nguyenhainam071205/IOT/Module_cam_bien_va_cong_thuc.docx

# Module cảm biến và công thức tính

Trạm đo lũ dùng ESP32: đo mực nước, lưu lượng và độ ẩm đất, gửi kết quả về web server qua HTTP POST JSON. Tài liệu này liệt kê các module đang dùng và công thức được cài trong firmware (thư mục firmware/).

# 1. Danh sách module

Module | Đại lượng đo | Chân ESP32 | Ghi chú đấu nối
HC-SR04 (siêu âm) | Khoảng cách từ cảm biến đến mặt nước, từ đó tính mực nước | TRIG: GPIO 25 ECHO: GPIO 26 | Cấp 5V (VIN). ECHO ra 5V nên phải qua cầu chia áp 1k/2k trước khi vào GPIO 26.
YF-S201 (lưu lượng) | Lưu lượng nước (L/phút) và tổng thể tích (L) | GPIO 27 | Cấp 5V (VIN). Dây vàng (xung) qua cầu chia áp 1k/2k. Đếm xung bằng ngắt cạnh xuống.
Cảm biến độ ẩm đất (LM393, ngõ AO) | Độ ẩm đất (%) | GPIO 34 (ADC) | Cấp 3V3. Đất khô cho ADC cao, đất ướt cho ADC thấp.

Vi điều khiển: ESP32 (ADC 12 bit, giá trị 0 đến 4095). Cầu chia áp 1k/2k hạ mức 5V xuống 5 x 2/(1+2) = 3,33V, an toàn cho chân GPIO của ESP32.

# 2. Cảm biến siêu âm HC-SR04 và mực nước

## 2.1. Khoảng cách

Cảm biến phát xung siêu âm, đo thời gian t (µs) từ lúc phát đến lúc nhận echo. Sóng đi và về nên chia đôi quãng đường:

v = 331,3 + 0,606 x T (m/s, T là nhiệt độ môi trường °C)

v_cm/µs = v / 10000

D = t x v_cm/µs / 2 + OFFSET_CM (cm)

Firmware dùng TEMP_C = 30 °C nên v = 349,48 m/s = 0,034948 cm/µs. OFFSET_CM = 0 (chỉnh sau khi so với thước). Mỗi mẫu thử tối đa 3 lần nếu mất echo (timeout 30 ms).

## 2.2. Lọc trung bình động

Lấy trung bình N = 5 mẫu gần nhất để giảm nhiễu. Nếu một mẫu mất echo thì giữ nguyên D_loc cũ.

D_loc = (1/N) x SUM( D[n-i] ), i = 0 .. N-1

## 2.3. Mực nước

H_nuoc = H_tram - D_loc (cm)

H_tram = 30 cm là chiều cao lắp cảm biến so với mốc chuẩn (đáy). Nếu H_nuoc < 0 thì coi như 0. Chỉ xét cảnh báo và gửi dữ liệu khi bộ lọc đã đủ 5 mẫu.

## 2.4. Mức cảnh báo

Mức | Điều kiện lên mức | Điều kiện hạ mức (có trễ)
Bình thường (normal) | H_nuoc < 4 cm | H_nuoc < 3,5 cm khi đang ở vàng
Vàng (yellow) | H_nuoc >= 4 cm | H_nuoc < 7,5 cm khi đang ở đỏ
Đỏ (red) | H_nuoc >= 8 cm | Không có mức cao hơn

Độ trễ HYST_CM = 0,5 cm: muốn hạ mức, mực nước phải tụt xuống dưới (ngưỡng - 0,5) để tránh nhấp nháy quanh ngưỡng. Mỗi lần đổi mức, ESP32 gửi ngay bản tin "alert".

## 2.5. Ví dụ

Echo đo được t = 1500 µs: D = 1500 x 0,034948 / 2 = 26,2 cm, nên H_nuoc = 30 - 26,2 = 3,8 cm (mức bình thường).

# 3. Cảm biến lưu lượng YF-S201

Cảm biến phát xung, mỗi cạnh xuống là 1 xung, được đếm bằng ngắt. Tần số xung tỉ lệ với lưu lượng theo datasheet:

f = 7,5 x Q => Q = f / 7,5 (f: Hz, Q: L/phút)

Trong mỗi chu kỳ đo (khoảng 1 giây, chia theo thời gian thực tế elapsed để chính xác khi chu kỳ dài hơn 1 s):

f = số_xung x 1000 / elapsed_ms (Hz)

Q = f / FLOW_K, FLOW_K = 7,5 (L/phút)

Tổng_L = Tổng_L + (Q / 60) x (elapsed_ms / 1000) (lít, cộng dồn)

Ví dụ: đếm được 15 xung trong 1 s thì f = 15 Hz, Q = 2 L/phút, thể tích tăng thêm 2/60 = 0,033 L. Hệ số 7,5 là giá trị danh định, nên hiệu chuẩn lại bằng cách đo một thể tích nước biết trước. Giá trị flow_lpm gửi lên server là giá trị tức thời của chu kỳ ngay trước khi gửi.

# 4. Cảm biến độ ẩm đất (LM393)

Đọc ADC 10 lần (cách nhau 2 ms) rồi lấy trung bình để giảm nhiễu, sau đó quy đổi tuyến tính giữa hai mốc hiệu chuẩn:

W = (ADC_kho - ADC) / (ADC_kho - ADC_uot) x 100 (%)

W được giới hạn trong khoảng [0, 100]

Hằng số | Giá trị | Ý nghĩa
ADC_KHO | 3500 | ADC khi đất khô hoàn toàn (để ngoài không khí)
ADC_UOT | 1400 | ADC khi đất ướt hoàn toàn (nhúng nước)

Hai mốc trên là giá trị ví dụ, cần đo lại bằng chính cảm biến của bạn. Ví dụ: ADC = 2450 thì W = (3500 - 2450) / (3500 - 1400) x 100 = 50%.

# 5. Dữ liệu gửi lên server

ESP32 gửi HTTP POST JSON tới /flood khi đổi mức cảnh báo (event = "alert") và định kỳ 5 giây một lần (event = "report"). Các trường:

Trường | Đơn vị | Nguồn
level | chuỗi | normal / yellow / red theo mục 2.4
h_nuoc_cm | cm | H_nuoc (mục 2.3)
d_loc_cm | cm | D_loc (mục 2.2)
h_tram_cm | cm | H_tram, hằng số cấu hình
flow_lpm | L/phút | Q (mục 3)
total_l | lít | Tổng thể tích cộng dồn (mục 3)
soil_pct | % | W (mục 4)

# 6. Tham số cấu hình

Toàn bộ hằng số nằm trong firmware/config.h:

Hằng số | Giá trị | Ý nghĩa
TEMP_C | 30,0 °C | Nhiệt độ bù tốc độ âm thanh
OFFSET_CM | 0,0 cm | Độ lệch cố định của HC-SR04
H_TRAM_CM | 30,0 cm | Chiều cao lắp cảm biến so với đáy
N_MA | 5 | Số mẫu của bộ lọc trung bình động
YELLOW_CM / RED_CM | 4,0 / 8,0 cm | Ngưỡng cảnh báo vàng / đỏ
HYST_CM | 0,5 cm | Độ trễ khi hạ mức
FLOW_K | 7,5 | Xung/giây ứng với 1 L/phút
ADC_KHO / ADC_UOT | 3500 / 1400 | Mốc hiệu chuẩn độ ẩm đất
INTERVAL_MS | 1000 ms | Chu kỳ đo và in Serial
REPORT_INTERVAL_MS | 5000 ms | Chu kỳ báo cáo định kỳ lên server
