nguyenhainam071205/IOT/(commit log)

2026-11-13 Cap nhat firmware: them module bao dong (den LED + coi) va hien thi LCD 1602 I2C
2026-11-13 Web: hien canh bao do am dat/luu luong, giao dien sang/toi, lam noi bat thoi tiet
    - Canh bao tung cam bien (do am dat, luu luong, lu quet) tren dau trang, vien mau theo muc
    - Bo bieu do sparkline o 3 the chi so
    - Bieu do muc nuoc co dinh 1 gio gan nhat
    - Them nut doi giao dien sang/toi (mac dinh sang, luu trong localStorage)
    - Lam noi bat khoi du bao thoi tiet, icon troi quang ban dem thanh mat trang
2026-11-13 Doi nguong cho hop cao 10 cm: H_TRAM 10, vang 4 cm, do 7 cm
2026-11-13 Cap nhat bao dong 3 cam bien (muc nuoc, do am, luu luong) tren ESP32 va hien thi du bao tren web
